PeraZver/Luvrid/Docs/3D Images/v3/Bottom.png

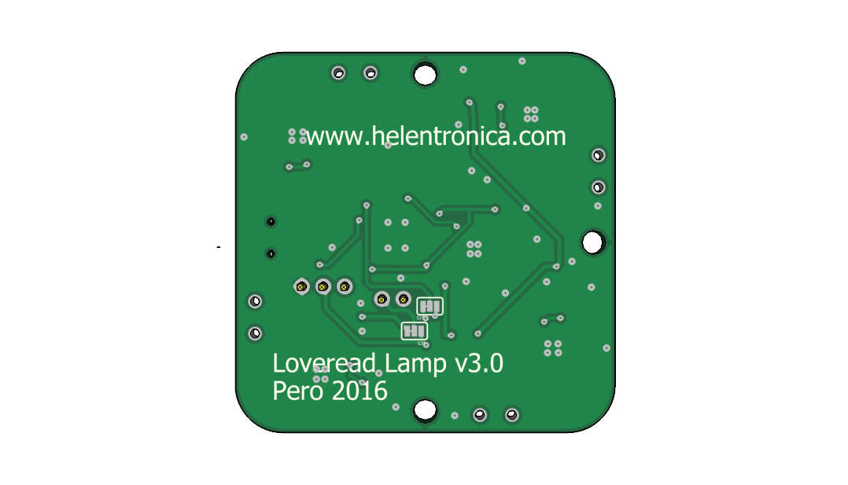
Docs/3D Images/v3/Bottom.png
