PeraZver/Luvrid/Docs/3D Images/v3/perspective2.png

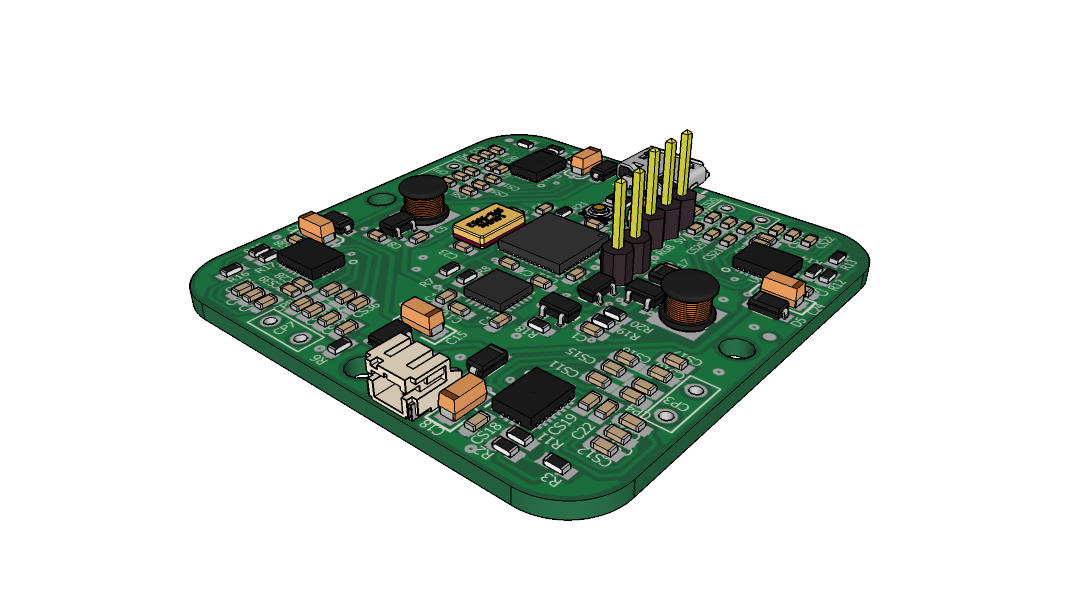
Docs/3D Images/v3/perspective2.png
