PeraZver/Luvrid/Docs/3D Images/v3/perspective.png

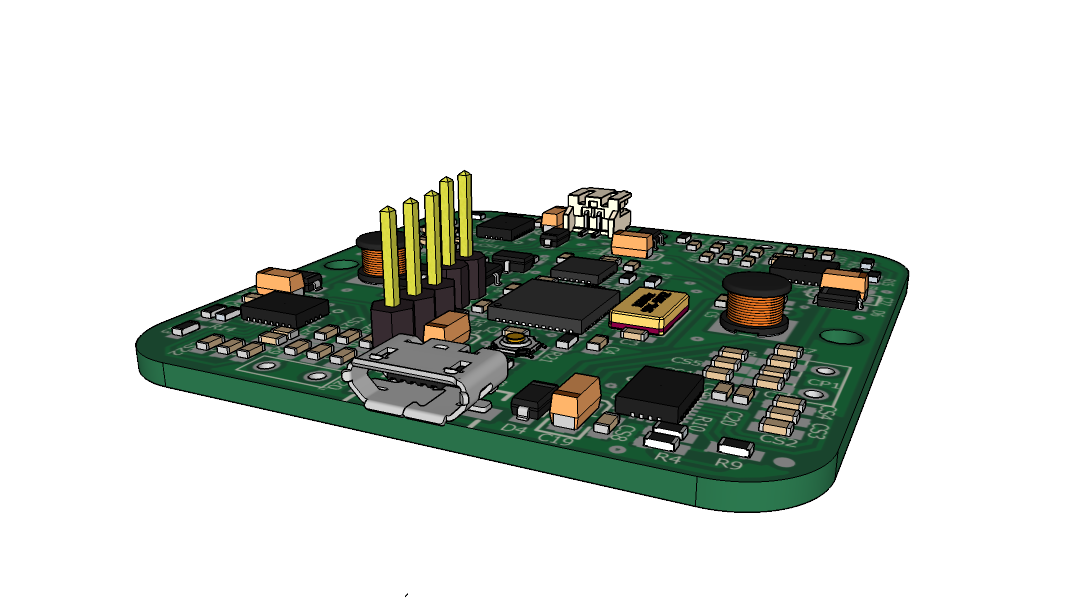
Docs/3D Images/v3/perspective.png
