PeraZver/Luvrid/Docs/3D Images/v3/Side.png

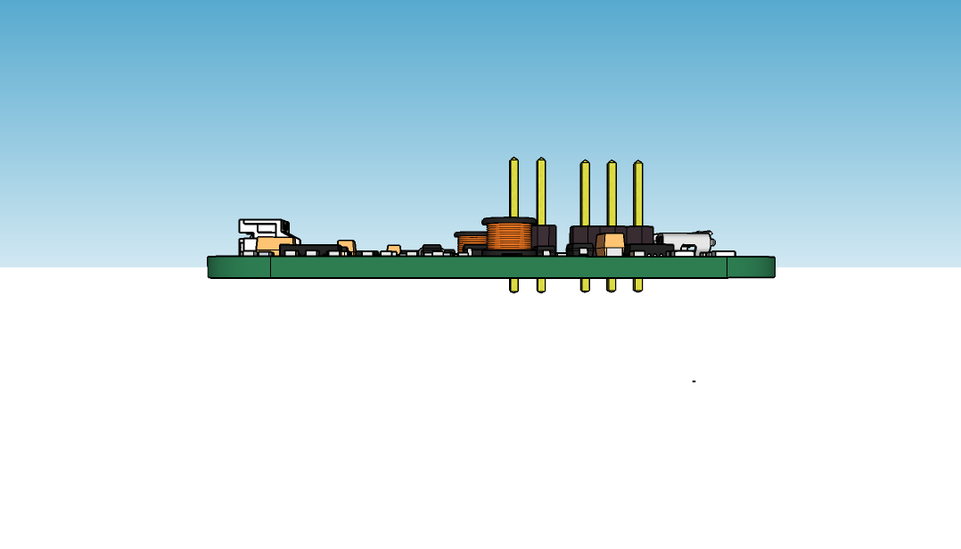
Docs/3D Images/v3/Side.png
