PeraZver/Luvrid/Docs/3D Images/v3/Top.png

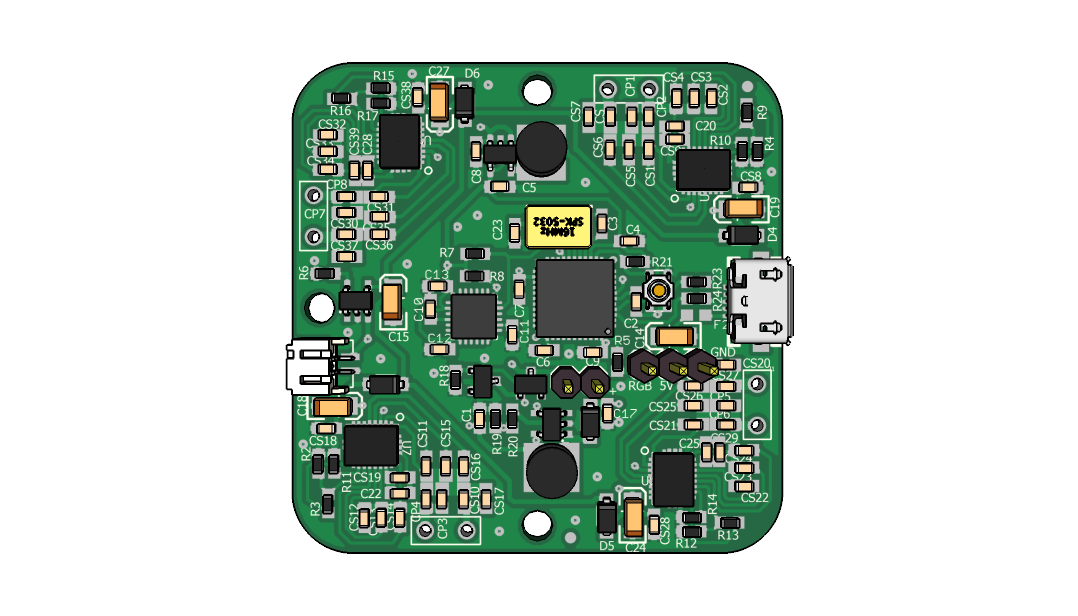
Docs/3D Images/v3/Top.png
