PeraZver/Luvrid/PCB/eagleUp/eagleUp_all_board_bottom.jpg

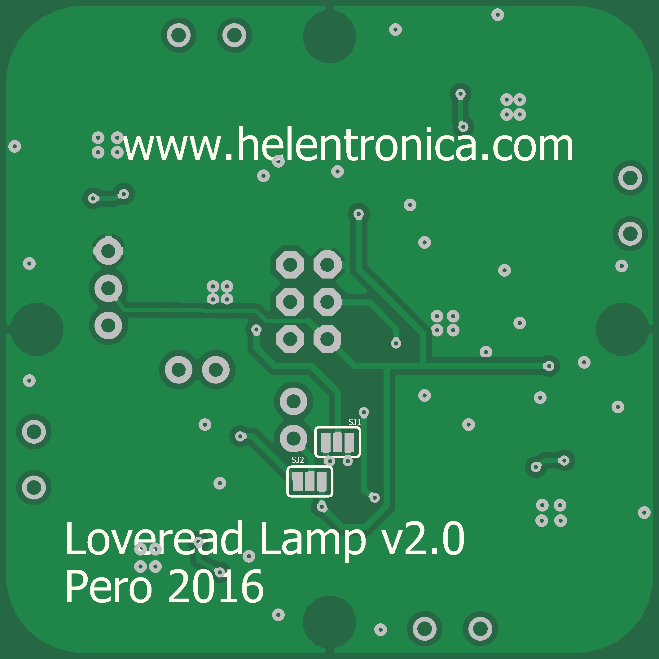
PCB/eagleUp/eagleUp_all_board_bottom.jpg
