PeraZver/Luvrid/PCB/eagleUp/eagleUp_all_board_bottom.png

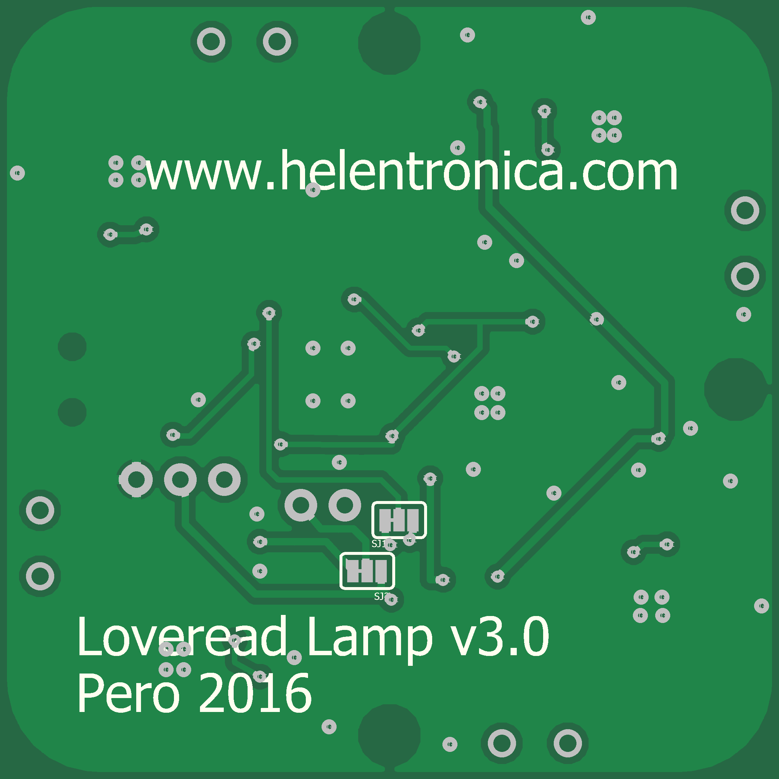
PCB/eagleUp/eagleUp_all_board_bottom.png
