PeraZver/Luvrid/PCB/eagleUp/eagleUp_all_board_top.jpg

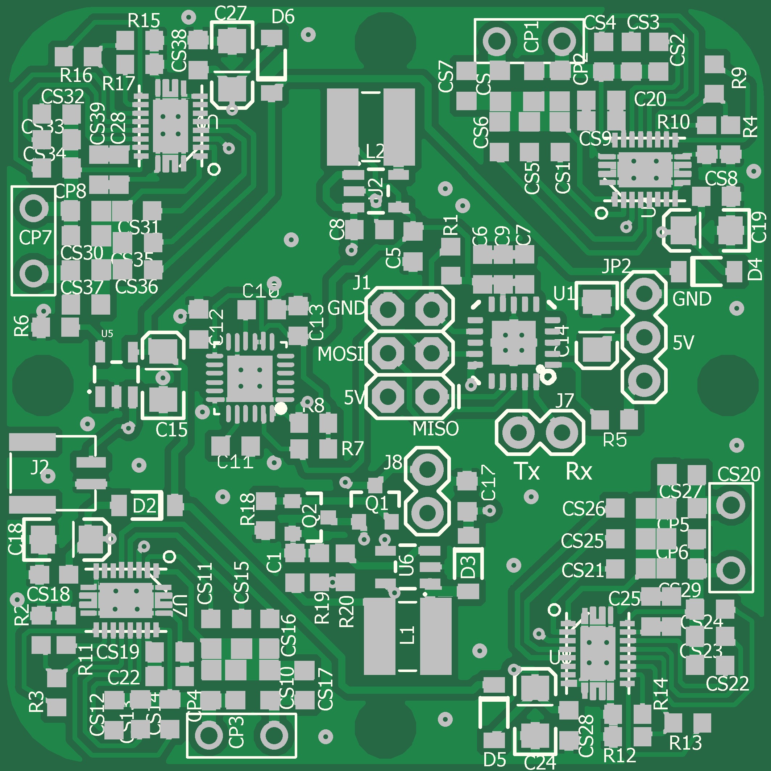
PCB/eagleUp/eagleUp_all_board_top.jpg
