PeraZver/Luvrid/PCB/eagleUp/eagleUp_all_board_top.png

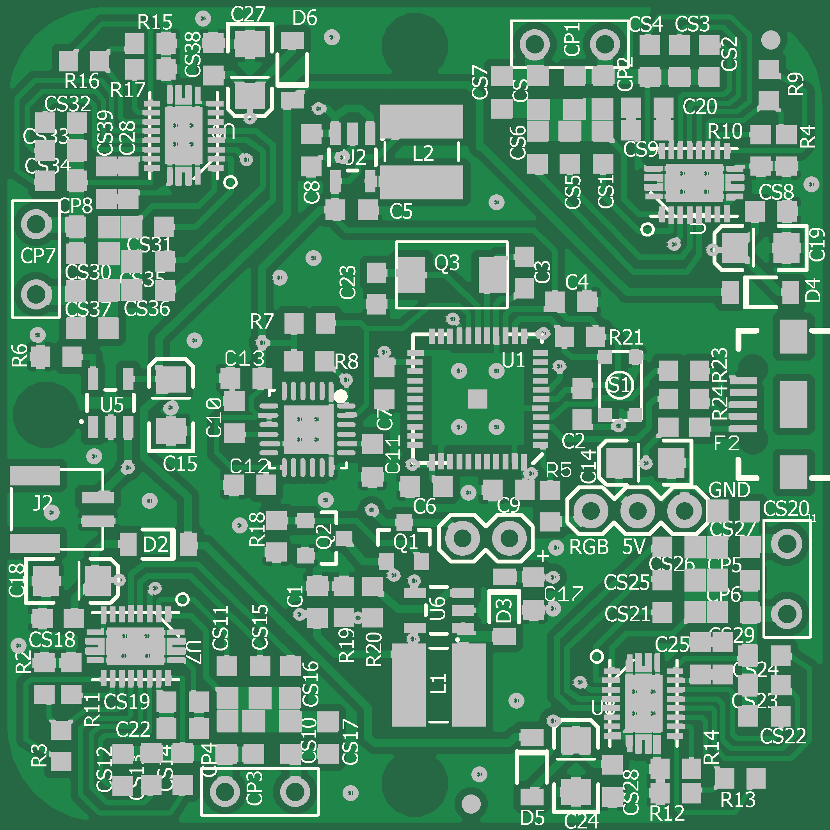
PCB/eagleUp/eagleUp_all_board_top.png
