PeraZver/Luvrid/(list of files, cad)

Other CAD files:
PCB/3D/Layout_v2.0.skp
PCB/3D/Test3D.skp
