PeraZver/Luvrid/Docs/Testing Qi Coils/Book1.xlsx

from the BQ51013 datasheet, page 29-31
 |  | Coils: | 862-6537 | 862-6530 | 923-6324
R, Ohm | 100 | f, kHz | 108.2 | 87.72 | 104.2
C, nF | 220 | f', kHz | 102 | 81.9 | 104.2
 |  | L_nom, uH | 10.7 | 16.2 | 11.8
fs, kHz | 100 | L_s, uH | 9.84 | 14.98 | 10.62 | 11
fD, kHz | 1000 | L_s', uH | 11.08 | 17.18 | 10.62 | 16
 |  | C1, nF | 228.888 | 147.56742 | 238.86808 | 158.4749888
 |  | C2, nF | 2.60490484 | 1.712501021 | 2.412808889 | 2.339114226
