PeraZver/Luvrid/PCB/Qi-Coil switch/Qi-Coil switch.pdf

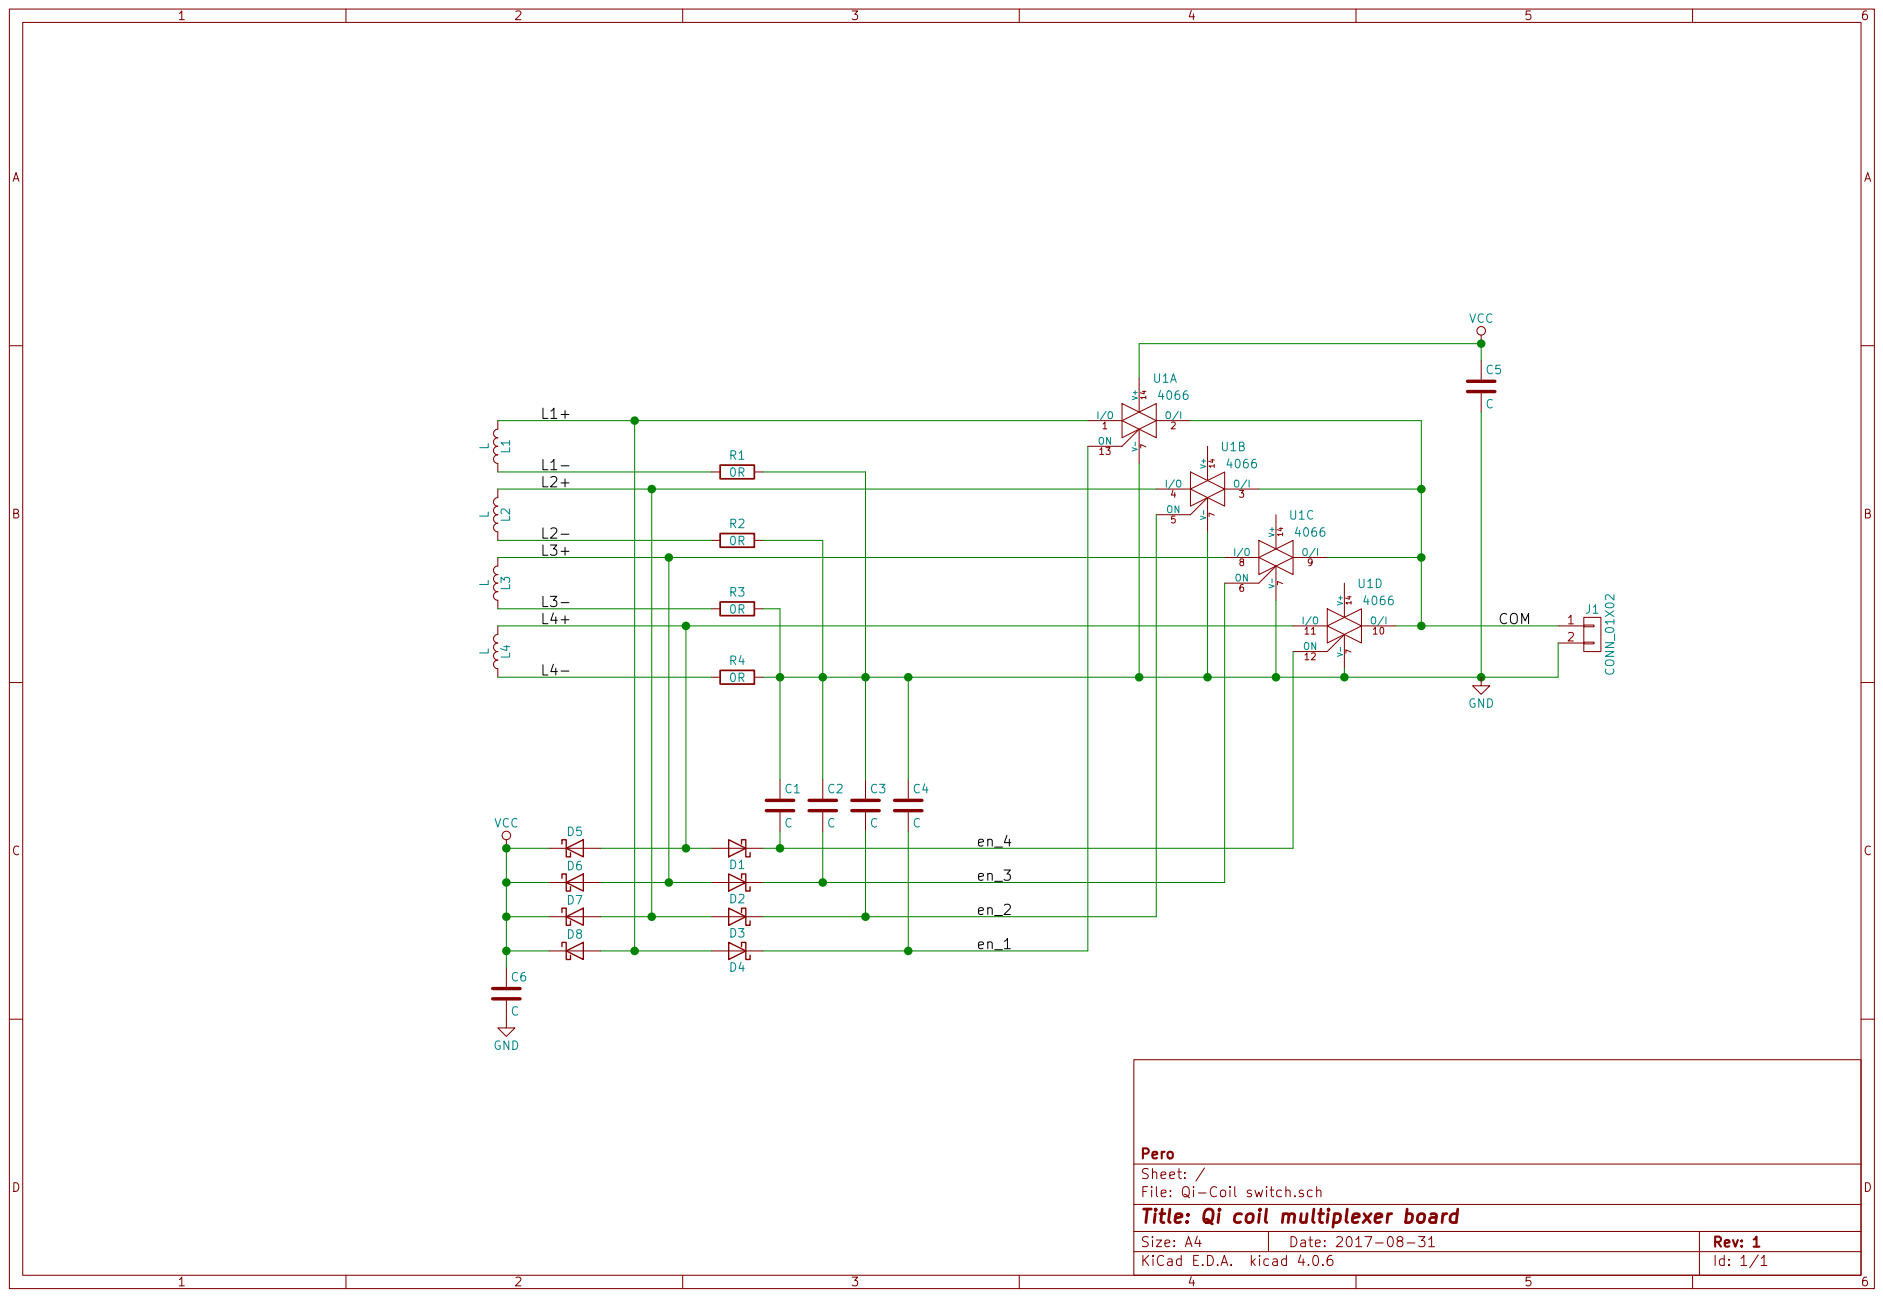
[picture p10: page 1]

VCC
File: Qi-Coil switch.sch Sheet: / Pero V-7 V+14

Id: 1/1 Title: Qi coil multiplexer board
