PeraZver/Luvrid/PCB/Qi-Coil switch/Qi-Coil switch-F.Fab.pdf

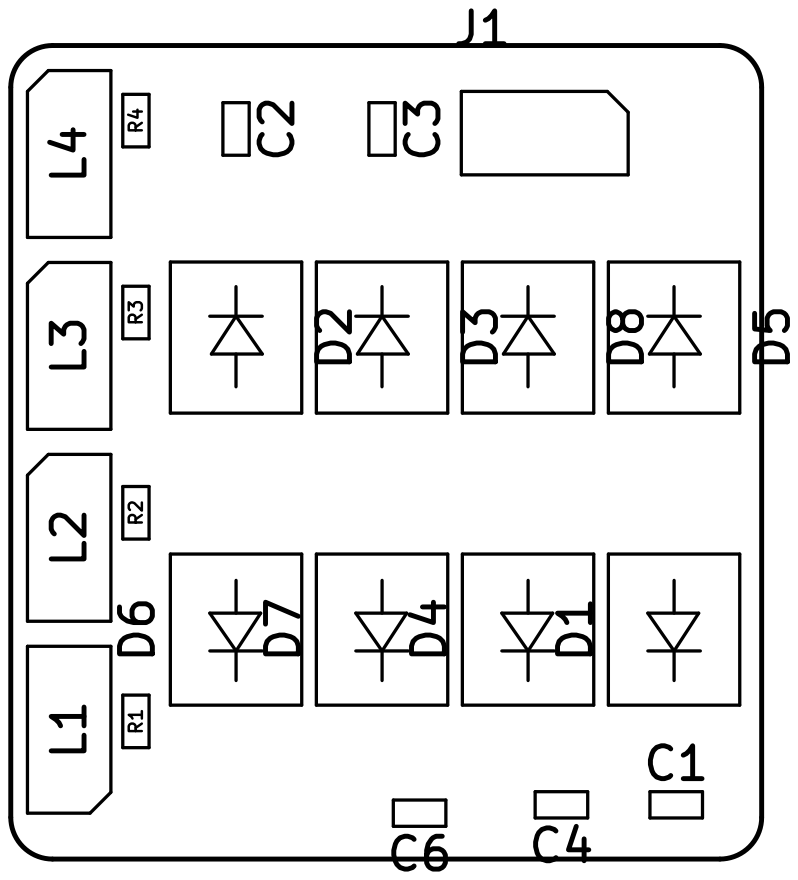
[picture p11: page 1]
