PeraZver/Luvrid/PCB/Qi-Coil switch/Qi-Coil switch-F.SilkS.pdf

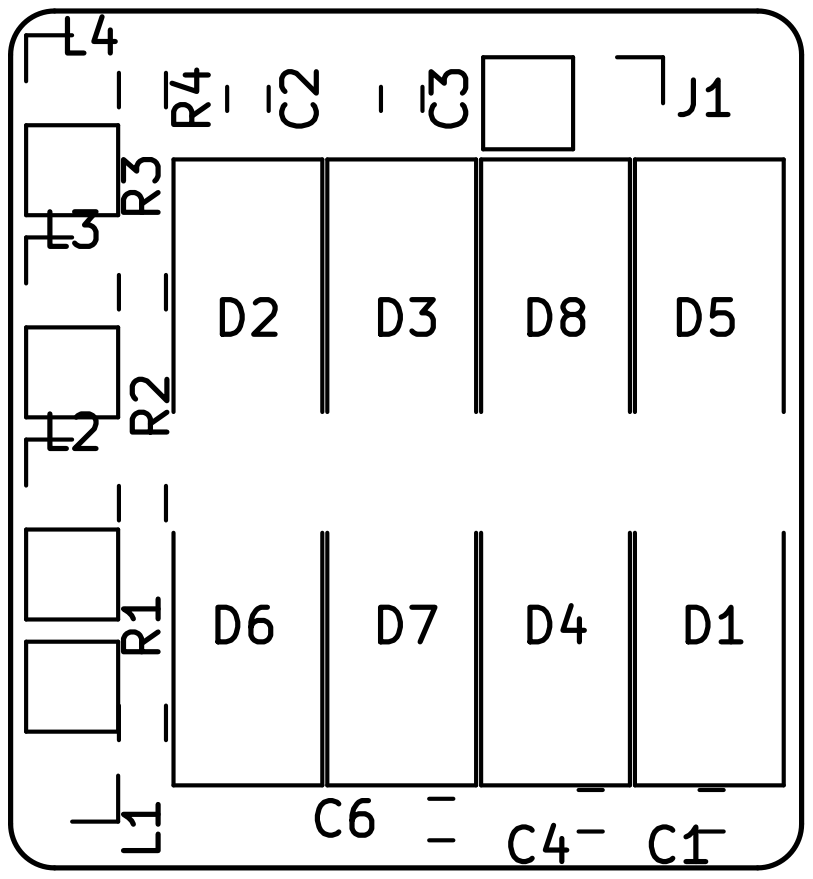
[picture p12: page 1]
