PeraZver/Luvrid/(list of files, drawings)

Other design files:
PCB/Qi-Coil switch/Qi-Coil switch.dsn
