PeraZver/Luvrid/PCB/Qi-Coil switch/Qi-Coil switch.kicad_pcb

## KiCad design PCB/Qi-Coil switch/Qi-Coil switch.kicad_pcb (2017-09-24)

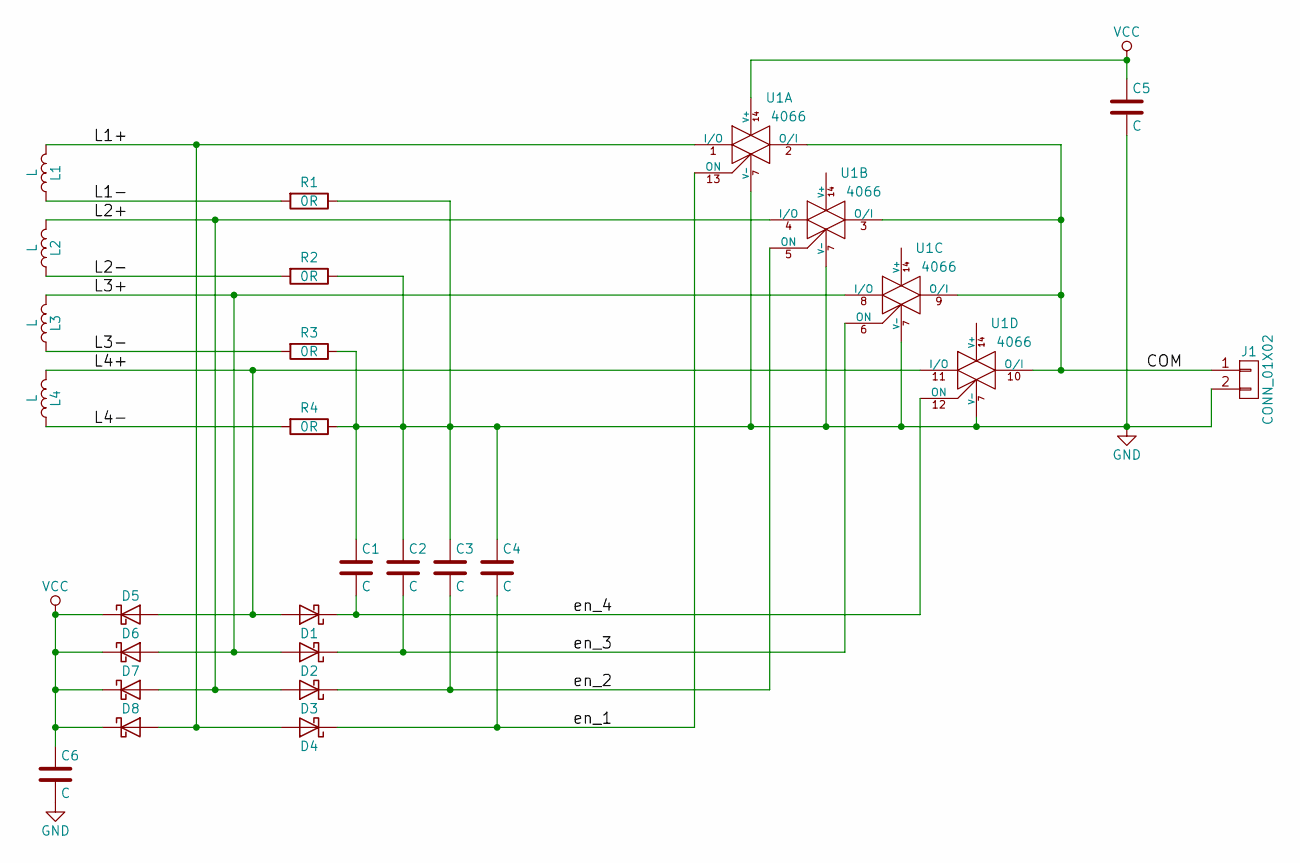
[picture p13: schematic Qi-Coil switch.sch, Qi coil multiplexer board]

Parts:
C1, C2, C3, C4, C6: C; C_0603_HandSoldering
C5: C; C_0805_HandSoldering
D1, D2, D3, D4, D5, D6, D7, D8: D_Schottky; D_SMB_Handsoldering
J1: CONN_01X02; Pin_Header_Straight_1x02_Pitch2.54mm
L1, L2, L3, L4: L; Pin_Header_Straight_1x02_Pitch2.54mm
R1, R2, R3, R4: 0R; R_0603_HandSoldering
U1: 4066; SSOP-14

Connections:
/COM: J1.1, U1.2 (O/I), U1.3 (O/I), U1.9 (O/I), U1.10 (O/I)
/L1+: D4.2 (A), D8.2 (A), L1.2, U1.1 (I/O)
/L1-: L1.1, R1.2
/L2+: D3.2 (A), D7.2 (A), L2.2, U1.4 (I/O)
/L2-: L2.1, R2.2
/L3+: D2.2 (A), D6.2 (A), L3.2, U1.8 (I/O)
/L3-: L3.1, R3.2
/L4+: D1.2 (A), D5.2 (A), L4.2, U1.11 (I/O)
/L4-: L4.1, R4.2
/en_1: C4.2, D4.1 (K), U1.13 (ON)
/en_2: C3.2, D3.1 (K), U1.5 (ON)
/en_3: C2.2, D2.1 (K), U1.6 (ON)
/en_4: C1.2, D1.1 (K), U1.12 (ON)
GND: C1.1, C2.1, C3.1, C4.1, C5.2, C6.2, J1.2, R1.1, R2.1, R3.1, R4.1, U1.7 (V-)
VCC: C5.1, C6.1, D5.1 (K), D6.1 (K), D7.1 (K), D8.1 (K), U1.14 (V+)

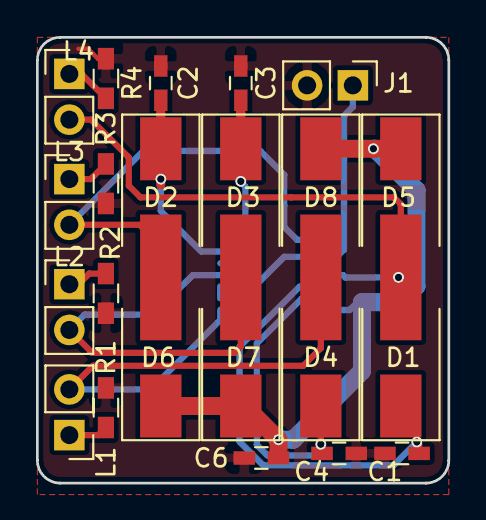
[picture p14: board Qi-Coil switch.kicad_pcb from above]

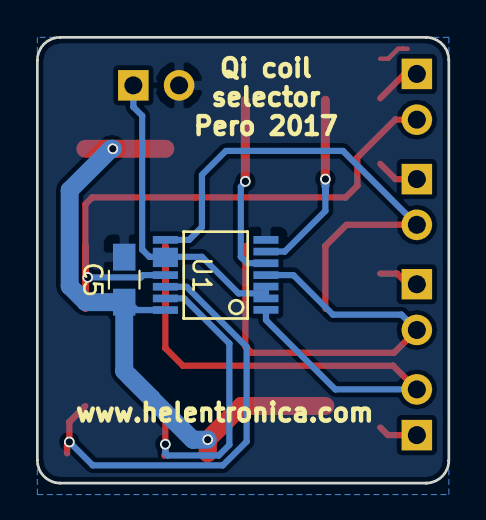
[picture p15: board Qi-Coil switch.kicad_pcb from below]

Board: 2 copper layers, 22.9 x 24.8 mm, 24 parts (2 on the bottom side), 15 nets.
