PeraZver/Luvrid/PCB/all.brd

## EAGLE design PCB/all.brd (2017-09-24)

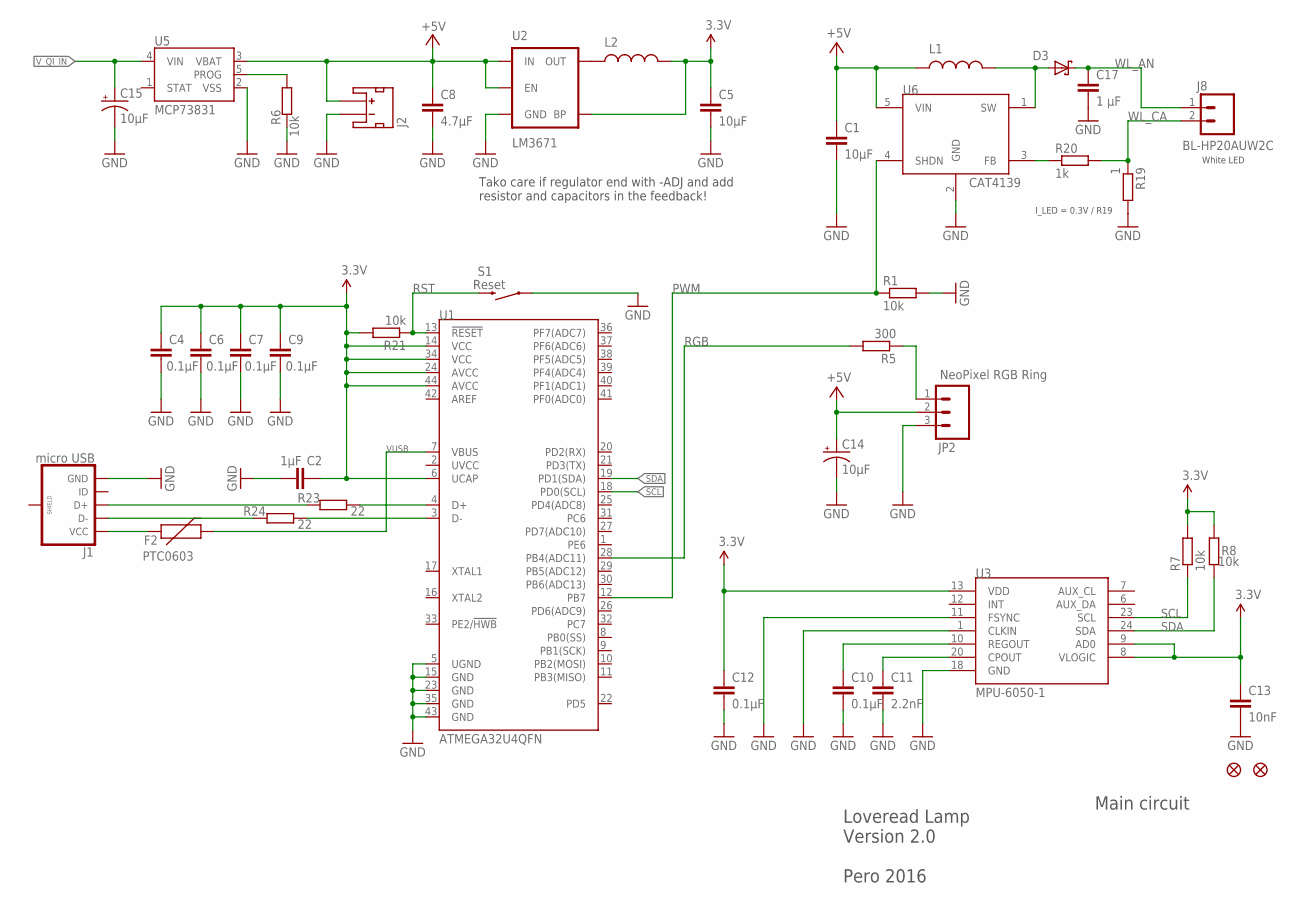
[picture p16: schematic all.sch, sheet 1]

Parts:
C1, C5: 10μF; C0603K
C2: 1µF; C0603
C4, C6, C7, C9, C10, C12: 0.1μF; C0603K
C8: 4.7μF; C0603K
C11: 2.2nF; C0603K
C13: 10nF; C0603K
C14, C15: 10μF; EIA3216
C17: 1 μF; C0603K
D3: SMF5.0AT1; SOD123FL
F2: PTC0603; 0603
FD1, FD2: FIDUCIAL1X2; FIDUCIAL-1X2
J1: micro USB; USB-B-MICRO-SMD_V03
J2: LIPO-BATTERY-CONNECTOR; JST-LIPO-CONNECTOR-1.25MM
J8: BL-HP20AUW2C; 1X02
JP2: NeoPixel RGB Ring; 1X03
L1: 22uH; SDR0403
L2: 2.2uH; SDR0403
R1, R6, R7, R8, R21: 10k; R0603
R5: 300; R0603
R19: 1; R0603
R20: 1k; R0603
R23, R24: 22; R0603
S1: Reset; TACTILE-SWITCH-SKSGAAE010
U1: ATMEGA32U4QFN; QFN-44
U2: LM3671; SOT23-5
U3: MPU-6050-1; QFN-24-4MM2
U5: MCP73831; SOT23-5
U6: CAT4139; SOT23-5

Connections:
3.3V: C2.1, C4.1, C5.1, C6.1, C7.1, C9.1, C12.1, C13.1, L2.P$2 (2), R7.2, R8.2, R21.2, U1.6 (UCAP), U1.14 (VCC), U1.24 (AVCC), U1.34 (VCC), U1.44 (AVCC), U2.4 (BP), U3.8 (VLOGIC), U3.9 (AD0), U3.13 (VDD)
+5V: C1.1, C8.1, C14.A (+), J2.P$1 (+), JP2.2, L1.P$1 (1), U2.1 (IN), U2.3 (EN), U5.3 (VBAT), U6.5 (VIN)
GND: C1.2, C2.2, C4.2, C5.2, C6.2, C7.2, C8.2, C9.2, C10.2, C11.2, C12.2, C13.2, C14.C (-), C15.C (-), C17.2, J1.GND, J2.P$2 (-), JP2.3, R1.2, R6.1, R19.2, S1.P$1 (1), S1.P$3 (1), U1.5 (UGND), U1.15 (GND), U1.23 (GND), U1.35 (GND), U1.43 (GND), U2.2 (GND), U3.1 (CLKIN), U3.11 (FSYNC), U3.18 (GND), U5.2 (VSS), U6.2 (GND); also elsewhere on the board
unnamed: C11.1, U3.20 (CPOUT)
unnamed: C10.1, U3.10 (REGOUT)
unnamed: JP2.1, R5.1
unnamed: R6.2, U5.5 (PROG)
unnamed: D3.A, L1.P$2 (2), U6.1 (SW)
unnamed: R20.1, U6.3 (FB)
unnamed: L2.P$1 (1), U2.5 (OUT)
unnamed: F2.1, J1.VBUS (VCC)
unnamed: J1.D+, R23.1
unnamed: J1.D-, R24.1
unnamed: R23.2, U1.4 (D+)
unnamed: R24.2, U1.3 (D-)
PWM: R1.1, U1.12 (PB7), U6.4 (SHDN)
RGB: R5.2, U1.28 (PB4(ADC11))
RST: R21.1, S1.P$2 (2), S1.P$4 (2), U1.13 (!RESET)
SCL: R7.1, U1.18 (PD0(SCL)), U3.23 (SCL)
SDA: R8.1, U1.19 (PD1(SDA)), U3.24 (SDA)
VUSB: F2.2, U1.7 (VBUS)
V_QI_IN: C15.A (+), U5.4 (VIN); also elsewhere on the board
WL_AN: C17.1, D3.C, J8.1
WL_CA: J8.2, R19.1, R20.2

Notes on the sheet:
Loveread Lamp Version 2.0 Pero 2016
Main circuit
I_LED = 0.3V / R19
White LED
Tako care if regulator end with -ADJ and add resistor and capacitors in the feedback!

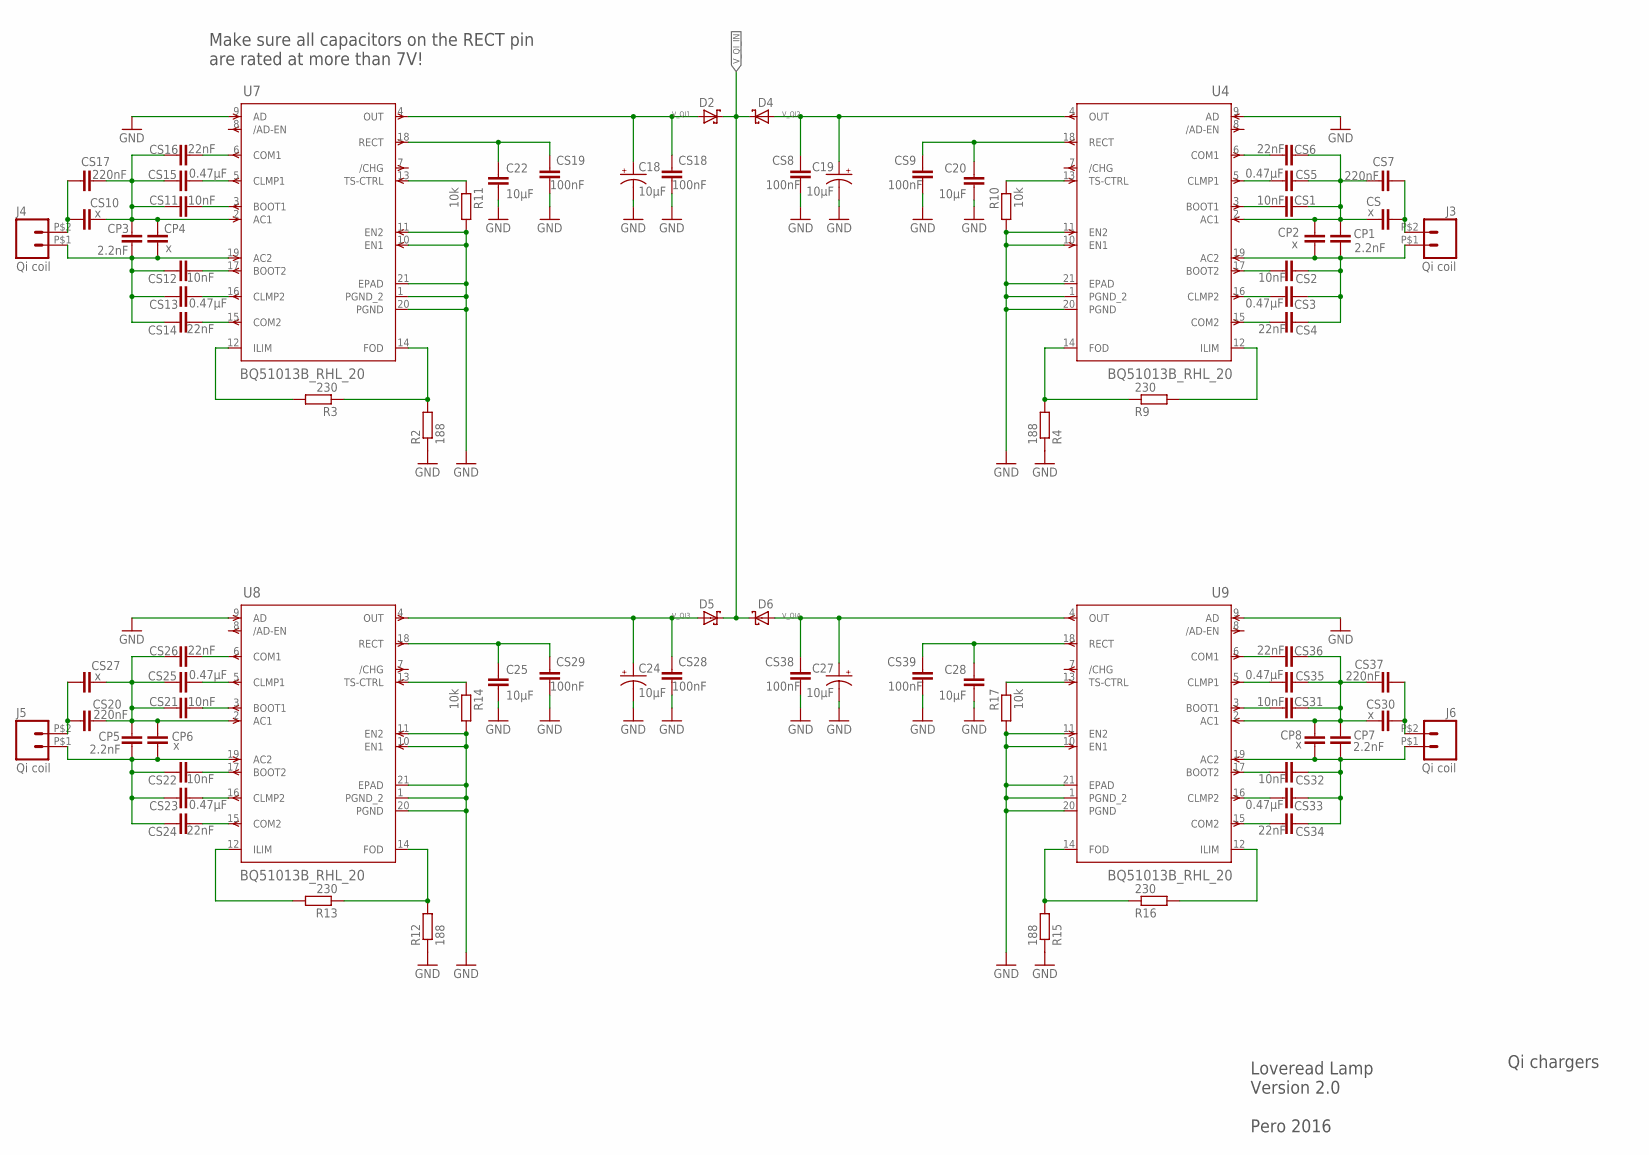
[picture p17: schematic all.sch, sheet 2]

Parts:
C18, C19, C24, C27: 10μF; EIA3216
C20, C22, C25, C28: 10μF; C0603K
CP1, CP3, CP5, CP7: 2.2nF; C0603K
CP2, CP4, CP6, CP8: x; C0603K
CS, CS10, CS27, CS30: x; C0603K
CS1, CS2, CS11, CS12, CS21, CS22, CS31, CS32: 10nF; C0603K
CS3, CS5, CS13, CS15, CS23, CS25, CS33, CS35: 0.47μF; C0603K
CS4, CS6, CS14, CS16, CS24, CS26, CS34, CS36: 22nF; C0603K
CS7, CS17, CS20, CS37: 220nF; C0603K
CS8, CS9, CS19, CS28, CS29, CS38, CS39: 100nF; C0603K
CS18: 100nF; C0603
D2, D4, D5, D6: SMF5.0AT1; SOD123FL
J3, J4, J5, J6: Qi coil; 1X02_BIG
R2, R4, R12, R15: 188; R0603
R3, R9, R13, R16: 230; R0603
R10, R11, R14, R17: 10k; R0603
U4, U7, U8, U9: BQ51013B_RHL_20; RHL20_2P05X3P05

Connections:
GND: C18.C (-), C19.C (-), C20.2, C22.2, C24.C (-), C25.2, C27.C (-), C28.2, CS8.2, CS9.2, CS18.2, CS19.2, CS28.2, CS29.2, CS38.2, CS39.2, R2.1, R4.1, R10.2, R11.2, R12.1, R14.2, R15.1, R17.2, U4.1 (PGND_2), U4.9 (AD), U4.10 (EN1), U4.11 (EN2), U4.20 (PGND), U4.21 (EPAD), U7.1 (PGND_2), U7.9 (AD), U7.10 (EN1), U7.11 (EN2), U7.20 (PGND), U7.21 (EPAD), U8.1 (PGND_2), U8.9 (AD), U8.10 (EN1), U8.11 (EN2), U8.20 (PGND), U8.21 (EPAD), U9.1 (PGND_2), U9.9 (AD), U9.10 (EN1), U9.11 (EN2), U9.20 (PGND), U9.21 (EPAD); also elsewhere on the board
unnamed: CS10.1, CS17.1, J4.P$2 (2)
unnamed: CP3.1, CP4.1, CS12.1, CS13.1, CS14.1, J4.P$1 (1), U7.19 (AC2)
unnamed: CP1.2, CP2.2, CS.2, CS1.1, CS5.1, CS6.1, CS7.2, U4.2 (AC1)
unnamed: CS.1, CS7.1, J3.P$2 (2)
unnamed: CP1.1, CP2.1, CS2.1, CS3.1, CS4.1, J3.P$1 (1), U4.19 (AC2)
unnamed: CS1.2, U4.3 (BOOT1)
unnamed: CS2.2, U4.17 (BOOT2)
unnamed: CS3.2, U4.16 (CLMP2)
unnamed: CS11.2, U7.3 (BOOT1)
unnamed: CS4.2, U4.15 (COM2)
unnamed: CS6.2, U4.6 (COM1)
unnamed: CS5.2, U4.5 (CLMP1)
unnamed: CS12.2, U7.17 (BOOT2)
unnamed: C20.1, CS9.1, U4.18 (RECT)
unnamed: R9.2, U4.12 (ILIM)
unnamed: R4.2, R9.1, U4.14 (FOD)
unnamed: R10.1, U4.13 (TS-CTRL)
unnamed: CS13.2, U7.16 (CLMP2)
unnamed: CS14.2, U7.15 (COM2)
unnamed: CS16.2, U7.6 (COM1)
unnamed: CS15.2, U7.5 (CLMP1)
unnamed: CP3.2, CP4.2, CS10.2, CS11.1, CS15.1, CS16.1, CS17.2, U7.2 (AC1)
unnamed: C22.1, CS19.1, U7.18 (RECT)
unnamed: R3.2, U7.12 (ILIM)
unnamed: R2.2, R3.1, U7.14 (FOD)
unnamed: R11.1, U7.13 (TS-CTRL)
unnamed: CS20.1, CS27.1, J5.P$2 (2)
unnamed: CP5.1, CP6.1, CS22.1, CS23.1, CS24.1, J5.P$1 (1), U8.19 (AC2)
unnamed: CS21.2, U8.3 (BOOT1)
unnamed: CS22.2, U8.17 (BOOT2)
unnamed: CS23.2, U8.16 (CLMP2)
unnamed: CS24.2, U8.15 (COM2)
unnamed: CS26.2, U8.6 (COM1)
unnamed: CS25.2, U8.5 (CLMP1)
unnamed: CP5.2, CP6.2, CS20.2, CS21.1, CS25.1, CS26.1, CS27.2, U8.2 (AC1)
unnamed: C25.1, CS29.1, U8.18 (RECT)
unnamed: R13.2, U8.12 (ILIM)
unnamed: R12.2, R13.1, U8.14 (FOD)
unnamed: R14.1, U8.13 (TS-CTRL)
unnamed: CS30.1, CS37.1, J6.P$2 (2)
unnamed: CP7.1, CP8.1, CS32.1, CS33.1, CS34.1, J6.P$1 (1), U9.19 (AC2)
unnamed: CS31.2, U9.3 (BOOT1)
unnamed: CS32.2, U9.17 (BOOT2)
unnamed: CS33.2, U9.16 (CLMP2)
unnamed: CS34.2, U9.15 (COM2)
unnamed: CS36.2, U9.6 (COM1)
unnamed: CS35.2, U9.5 (CLMP1)
unnamed: CP7.2, CP8.2, CS30.2, CS31.1, CS35.1, CS36.1, CS37.2, U9.2 (AC1)
unnamed: C28.1, CS39.1, U9.18 (RECT)
unnamed: R16.2, U9.12 (ILIM)
unnamed: R15.2, R16.1, U9.14 (FOD)
unnamed: R17.1, U9.13 (TS-CTRL)
V_QI1: C18.A (+), CS18.1, D2.A, U7.4 (OUT)
V_QI2: C19.A (+), CS8.1, D4.A, U4.4 (OUT)
V_QI3: C24.A (+), CS28.1, D5.A, U8.4 (OUT)
V_QI4: C27.A (+), CS38.1, D6.A, U9.4 (OUT)
V_QI_IN: D2.C, D4.C, D5.C, D6.C; also elsewhere on the board

Notes on the sheet:
Loveread Lamp Version 2.0 Pero 2016
Qi chargers
Make sure all capacitors on the RECT pin are rated at more than 7V!

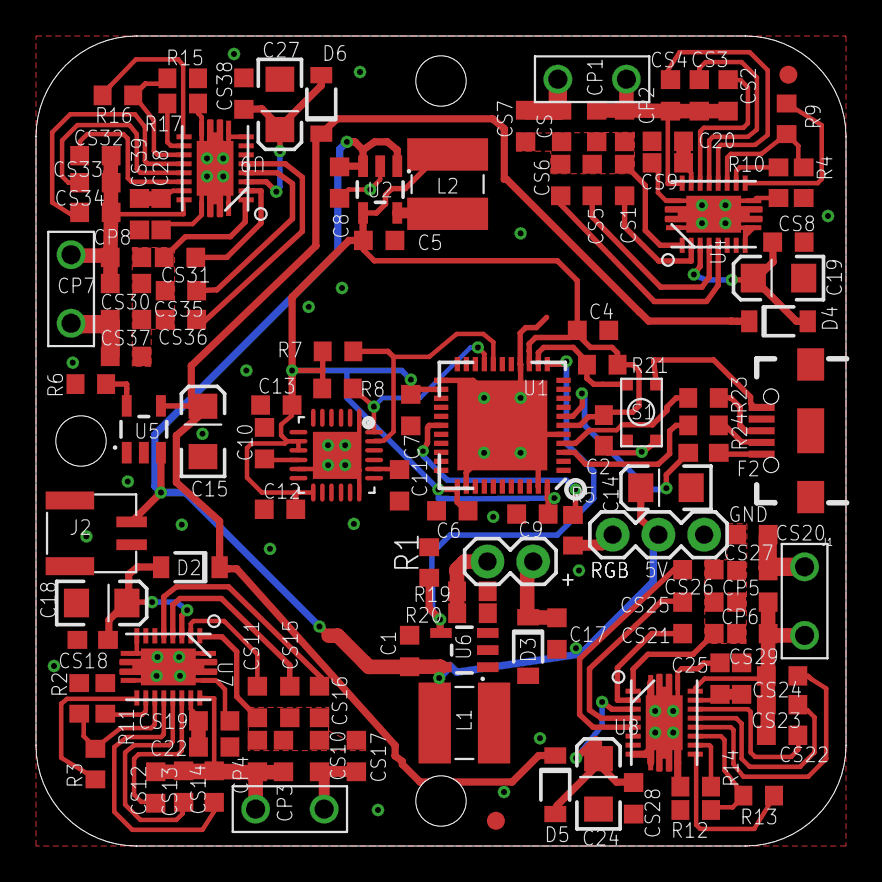
[picture p18: board all.brd from above]

Board: 2 copper layers, 45.0 x 45.0 mm, 123 parts (0 on the bottom side), 80 nets.

Other parts of the board:
DRILEGEND: DRILEGEND
U$1: Loveread Lamp v2.0; A4L-LOC
