PeraZver/Luvrid/(commit log)

2016-03-09 First commit of the Loveread Lamp Project.
    [32U4_Breakout-v11.brd, 32U4_Breakout-v11.sch, PowerCell-v13.brd, PowerCell-v13.sch, Triple_Axis_Accelerometer-Gyro_Breakout_-_MPU-6050_v12.sch, Triple_Axis_Accelerometer_-_Gyro_Breakout_-_MPU-6050_v12.brd, all.brd, all.sch]
2016-03-09 Still playing with GIT - this time I wanted to see how does it recognize the changes in Eagle files.
    [all.sch]
2016-07-17 Symmetrical Intensity calculation for both lamps
    [BOM.xlsx]
2016-07-26 added 3D models
    [32U4_Breakout-v11.brd, 32U4_Breakout-v11.sch, PowerCell-v13.brd, PowerCell-v13.sch, Triple_Axis_Accelerometer-Gyro_Breakout_-_MPU-6050_v12.sch, Triple_Axis_Accelerometer_-_Gyro_Breakout_-_MPU-6050_v12.brd, all.brd, all.sch]
2016-07-26 Add 3D model
    [Test3D.skp]
2016-07-31 Adding Qi receiver modules
    [all.brd, all.sch]
2016-07-31 Adding Tiny163 4 instead of mega32u4
    [all.brd, all.sch]
2016-08-02 Two-sheet schematics, and routing Qi chargers
    [all.brd, all.sch]
2016-08-23 Qi chargers routed
    [all.brd, all.sch]
2016-08-25 LED driver changed
    [all.brd, all.sch]
2016-08-25 Adds buck converter
    [all.brd, all.sch]
2016-08-26 rerouted Qi chargers and finished arrangements
    [all.brd, all.sch]
2016-08-26 Component placement
    [all.brd, all.sch]
2016-08-27 routing finished
    [all.brd, all.sch]
2016-08-27 DRC done
    [DRILEGEND.CFG, all.brd, all.sch]
2016-08-28 gerber generated
    [BOM.xlsx, all.brd, all.sch, stencil.dwg, stencil.dxf]
2016-08-28 remove pdf files
    [Layout_v2.0.skp]
2016-08-29 improved spacing, added silkscreen
    [all.brd]
2016-08-29 fix untracked files
    [Layout_v2.0.skp, all.brd]
2016-08-30 fabrication output generated
    [all.brd, all.sch]
2016-11-13 going back to 32u4
    [all.brd, all.sch]
2016-11-13 started routing with 32u4
    [all.brd, all.sch]
2016-11-15 order complete
    [all.brd]
2017-02-26 version 3.0 complete release
    [BOM.csv, BOM.xlsx, Book1.xlsx, all.brd, all.sch]
2017-05-08 no xtal and no transistor LED drivers
    [all.brd, all.sch]
2017-09-24 qi coil switch prototype
    [Qi-Coil switch.dsn, Qi-Coil switch.kicad_pcb, Qi-Coil switch.sch, all.brd, all.sch]
